solderparty/bbq20kbd_hw/bbq20_keyboard_case.step

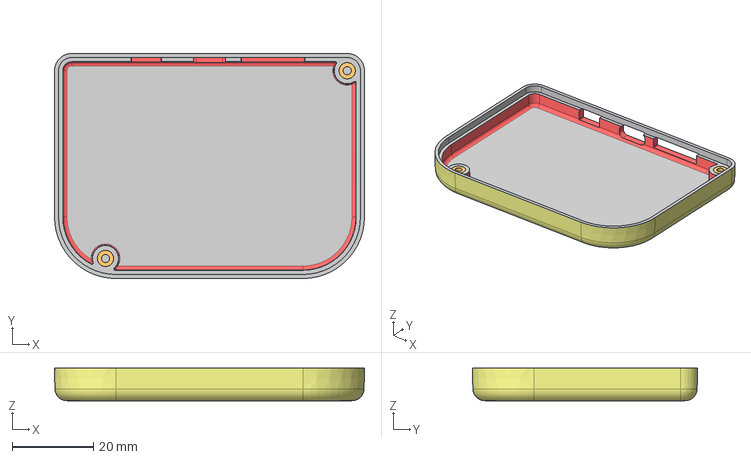
[picture p3: CAD file, 2022-05-10]
bbq20_keyboard_case.step
76.3 x 55.4 x 8.00 mm
