solderparty/bbq20kbd_hw/schematics.pdf

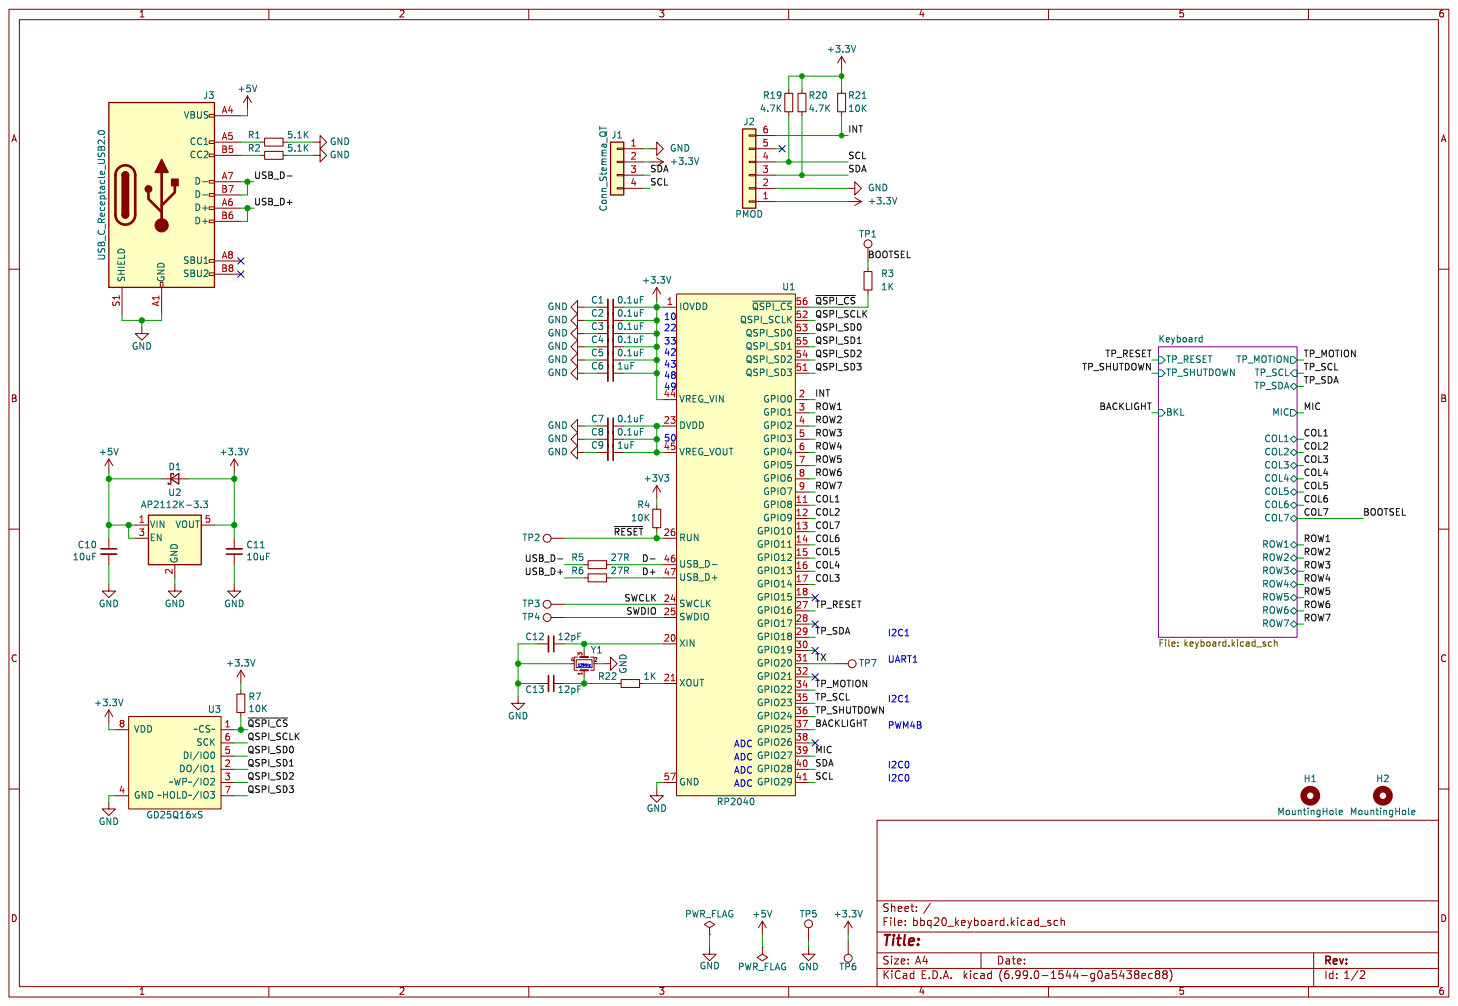
[picture p4: page 1]

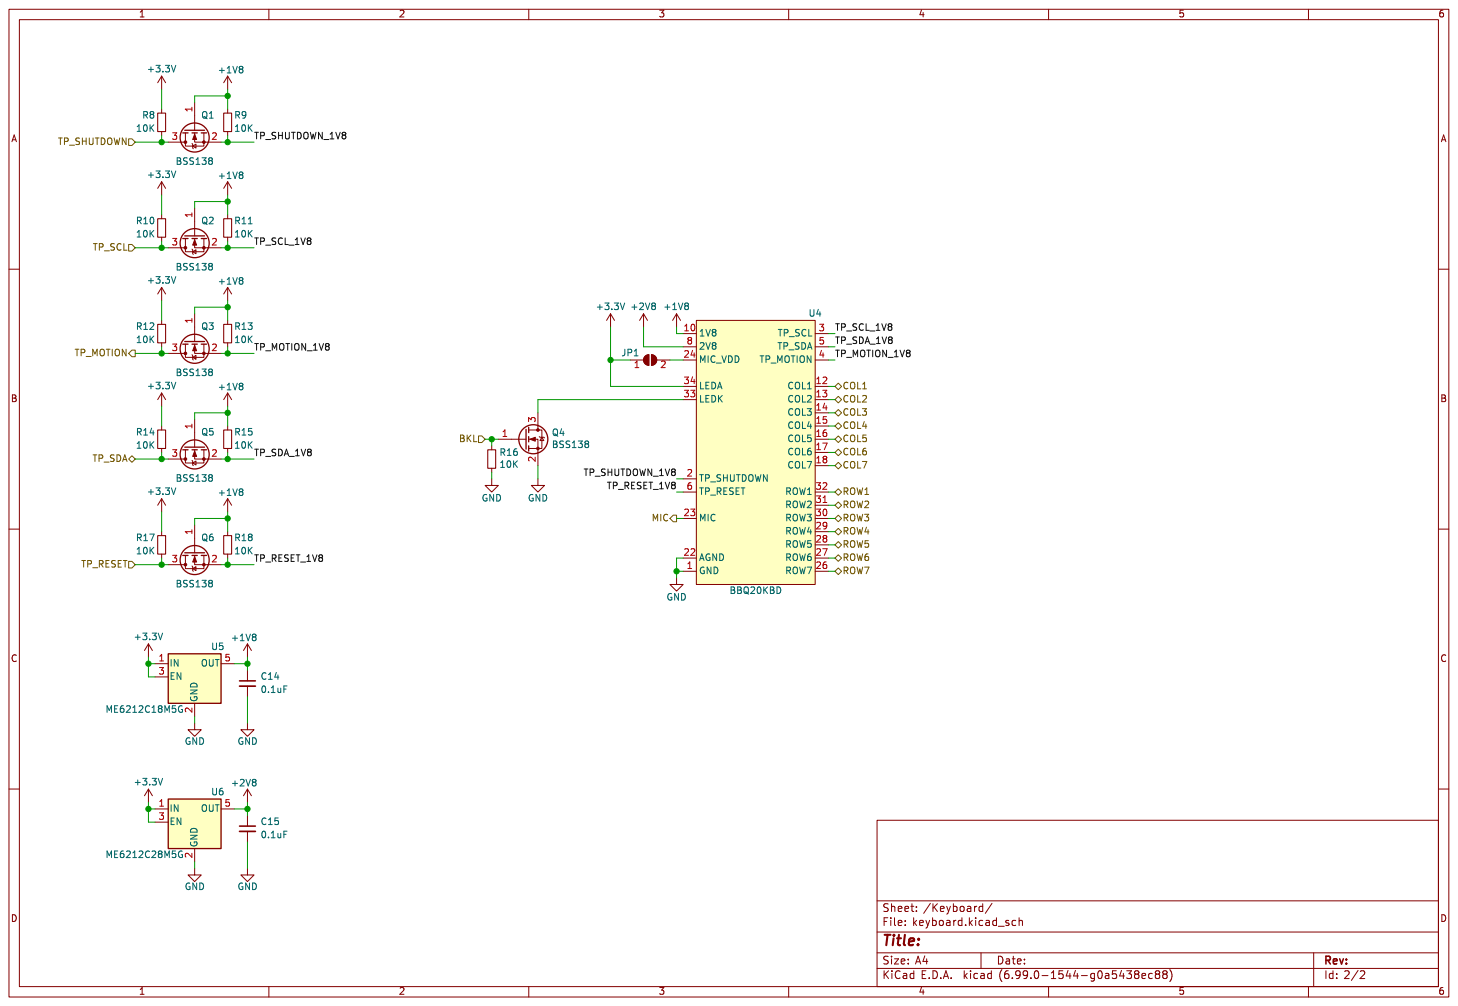
[picture p5: page 2]
