solderparty/bbq20kbd_hw/bbq20_keyboard.kicad_sch

## KiCad design bbq20_keyboard.kicad_sch (2022-05-07)

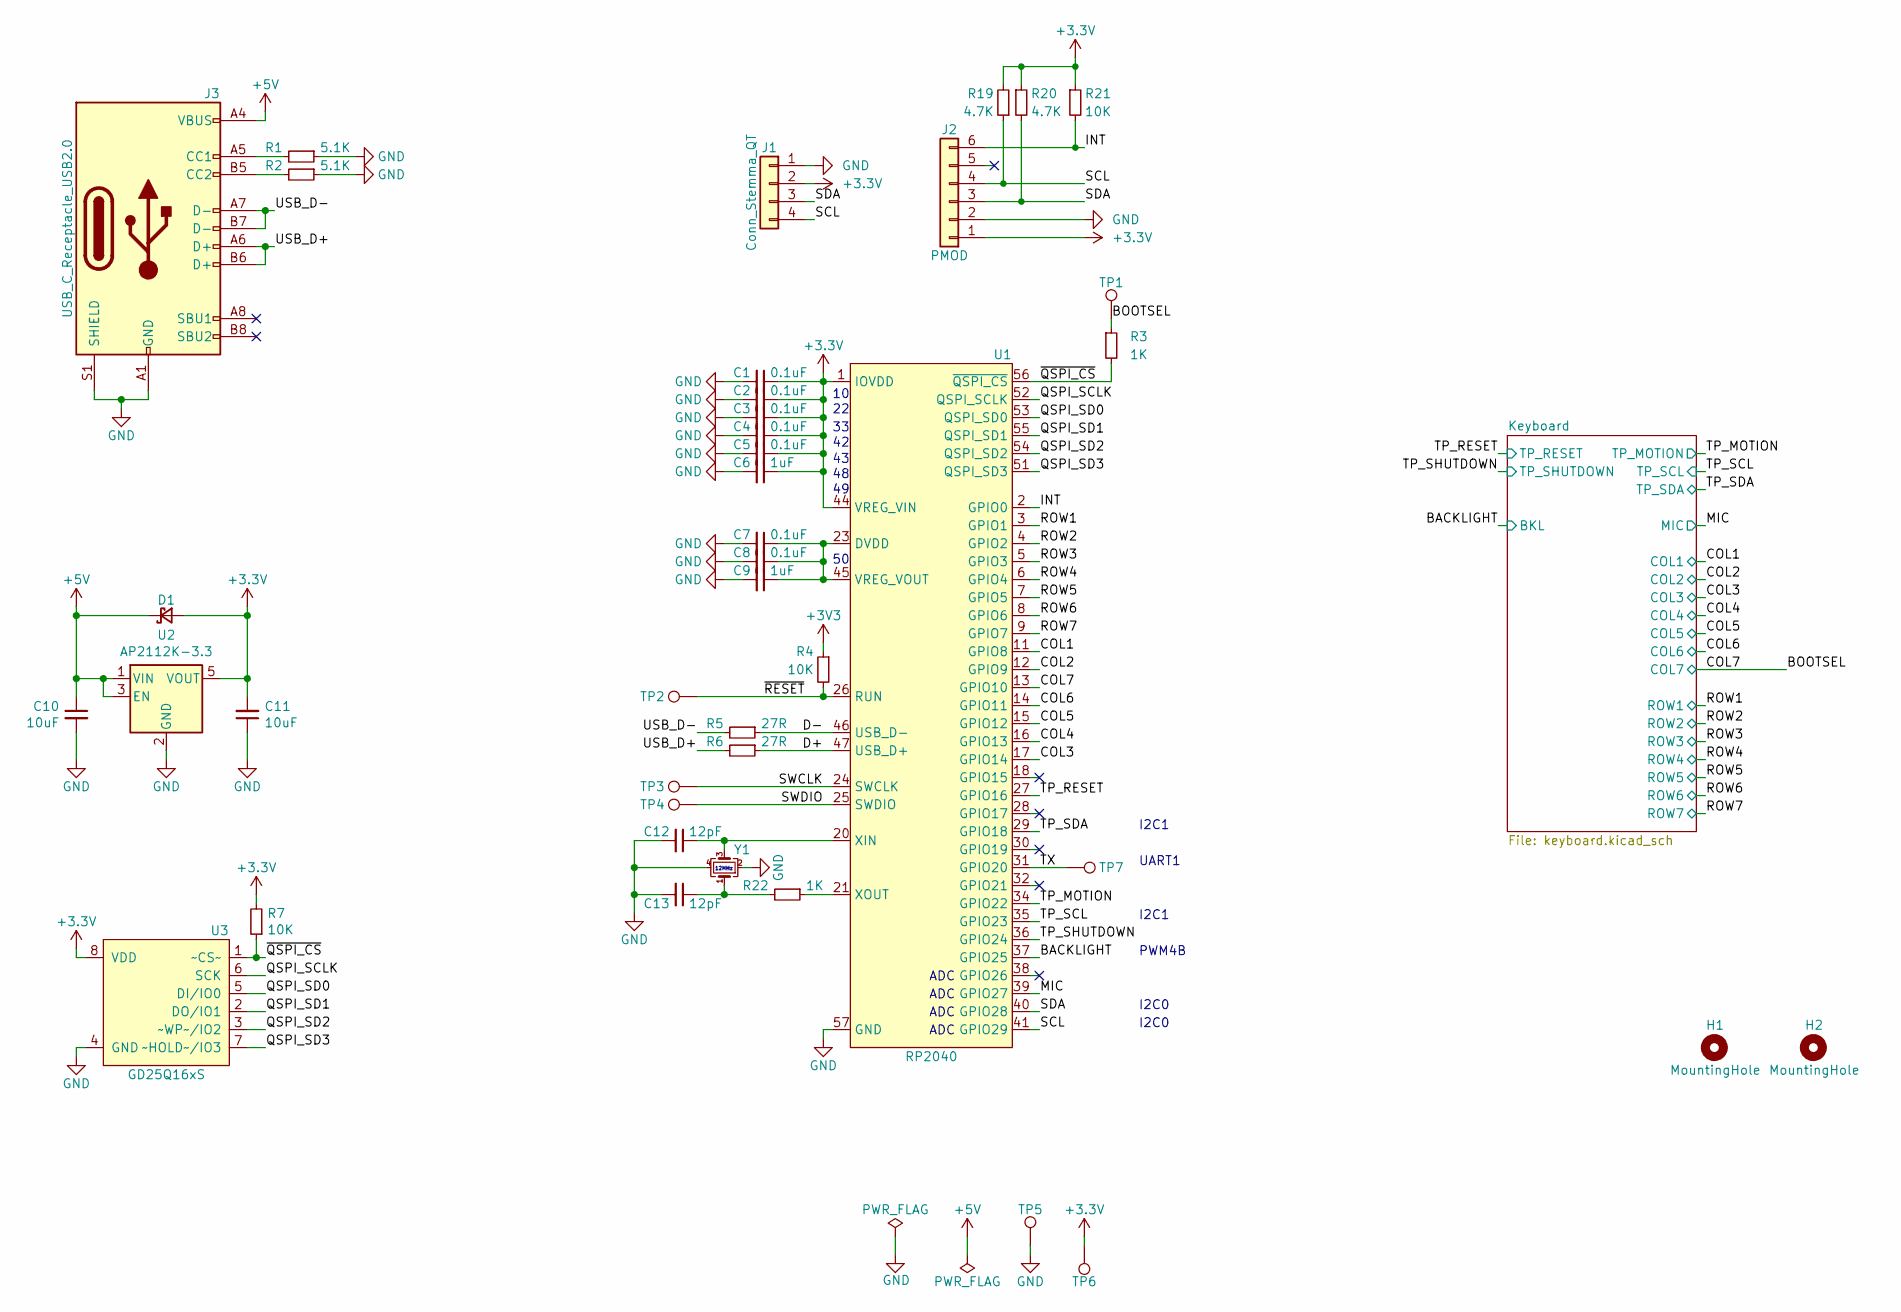
[picture p6: schematic bbq20_keyboard.kicad_sch]

Parts:
C1, C2, C3, C4, C5, C7, C8: 0.1uF; C_0603_1608Metric
C6, C9: 1uF; C_0603_1608Metric
C10, C11: 10uF; C_0603_1608Metric
C12, C13: 12pF; C_0603_1608Metric
D1: D_Schottky_Small; D_SOD-323; LCSC C114023
H1, H2: MountingHole; MountingHole_2.7mm_M2.5
J1: Conn_Stemma_QT; JST_SH_SM04B-SRSS-TB_1x04-1MP_P1.00mm_Horizontal; LCSC C145956
J2: PMOD; PMODPinHeader_1x06_P2.54mm_Horizontal
J3: USB_C_Receptacle_USB2.0; USB_C_Receptacle_HRO_TYPE-C-31-M-12; LCSC C165948
R1, R2: 5.1K; R_0603_1608Metric
R3, R22: 1K; R_0603_1608Metric
R4, R7, R21: 10K; R_0603_1608Metric
R5, R6: 27R; R_0603_1608Metric
R19, R20: 4.7K; R_0603_1608Metric
TP1: TP_USBBOOT; TestPoint_Pad_D1.5mm
TP2: TP_RESET; TestPoint_Pad_D1.5mm
TP3: TP_SWCLK; TestPoint_Pad_D1.5mm
TP4: TP_SWDIO; TestPoint_Pad_D1.5mm
TP5: TP_GND; TestPoint_Pad_D1.5mm
TP6: TP_3V3; TestPoint_Pad_D1.5mm
TP7: TP_TX; TestPoint_Pad_D1.5mm
U1: RP2040; QFN-56_EP_7x7_Pitch0.4mm
U2: AP2112K-3.3; SOT-23-5; LCSC C51118
U3: GD25Q16xS; SSOP-8_5.25x5.24mm_P1.27mm; LCSC C79074
Y1: XYDBPCNANF-12MHZ; Crystal_SMD_2520-4Pin_2.5x2.0mm; LCSC C709001

Connections:
+3.3V: C1.1, C2.1, C3.1, C4.1, C5.1, C6.1, C11.2, D1.2 (A), J1.2, J2.1, R7.2, R19.2, R20.1, R21.1, TP6.1, U1.1 (IOVDD), U1.10 (IOVDD), U1.22 (IOVDD), U1.33 (IOVDD), U1.42 (IOVDD), U1.43 (ADC_AVDD), U1.44 (VREG_VIN), U1.48 (USB_VDD), U1.49 (IOVDD), U2.5 (VOUT), U3.8 (VDD)
+3V3: R4.1
+5V: C10.1, D1.1 (K), J3.A4 (VBUS), J3.A9 (VBUS), J3.B4 (VBUS), J3.B9 (VBUS), U2.1 (VIN), U2.3 (EN)
BACKLIGHT: U1.37 (GPIO25)
BOOTSEL: R3.1, TP1.1, U1.13 (GPIO10)
COL1: U1.11 (GPIO8)
COL2: U1.12 (GPIO9)
COL3: U1.17 (GPIO14)
COL4: U1.16 (GPIO13)
COL5: U1.15 (GPIO12)
COL6: U1.14 (GPIO11)
D+: R6.1, U1.47 (USB_D+)
D-: R5.1, U1.46 (USB_D-)
GND: C1.2, C2.2, C3.2, C4.2, C5.2, C6.2, C7.2, C8.2, C9.2, C10.2, C11.1, C12.2, C13.2, J1.1, J2.2, J3.A1 (GND), J3.A12 (GND), J3.B1 (GND), J3.B12 (GND), J3.S1 (SHIELD), R1.1, R2.1, TP5.1, U1.19 (TESTEN), U1.57 (GND), U2.2 (GND), U3.4 (GND), U3.9 (GND), Y1.2, Y1.4
INT: J2.6, R21.2, U1.2 (GPIO0)
MIC: U1.39 (GPIO27)
unnamed: C7.1, C8.1, C9.1, U1.23 (DVDD), U1.45 (VREG_VOUT), U1.50 (DVDD)
unnamed: C12.1, U1.20 (XIN), Y1.3
unnamed: C13.1, R22.2, Y1.1
unnamed: J3.A5 (CC1), R1.2
unnamed: J3.B5 (CC2), R2.2
unnamed: R22.1, U1.21 (XOUT)
QSPI_SCLK: U1.52 (QSPI_SCLK), U3.6 (SCK)
QSPI_SD0: U1.53 (QSPI_SD0), U3.5 (DI/IO0)
QSPI_SD1: U1.55 (QSPI_SD1), U3.2 (DO/IO1)
QSPI_SD2: U1.54 (QSPI_SD2), U3.3 (~WP~/IO2)
QSPI_SD3: U1.51 (QSPI_SD3), U3.7 (~HOLD~/IO3)
ROW1: U1.3 (GPIO1)
ROW2: U1.4 (GPIO2)
ROW3: U1.5 (GPIO3)
ROW4: U1.6 (GPIO4)
ROW5: U1.7 (GPIO5)
ROW6: U1.8 (GPIO6)
ROW7: U1.9 (GPIO7)
SCL: J1.4, J2.4, R19.1, U1.41 (GPIO29)
SDA: J1.3, J2.3, R20.2, U1.40 (GPIO28)
SWCLK: TP3.1, U1.24 (SWCLK)
SWDIO: TP4.1, U1.25 (SWDIO)
TP_MOTION: U1.34 (GPIO22)
TP_RESET: U1.27 (GPIO16)
TP_SCL: U1.35 (GPIO23)
TP_SDA: U1.29 (GPIO18)
TP_SHUTDOWN: U1.36 (GPIO24)
TX: TP7.1, U1.31 (GPIO20)
USB_D+: J3.A6 (D+), J3.B6 (D+), R6.2
USB_D-: J3.A7 (D-), J3.B7 (D-), R5.2
~QSPI_CS: R3.2, R7.1, U1.56 (~QSPI_CS), U3.1 (~CS~)
~RESET: R4.2, TP2.1, U1.26 (RUN)

Notes on the sheet:
12MHz
ADC
I2C1
UART1
PWM4B
I2C0
