solderparty/bbq20kbd_hw/(commit log)

2022-03-07 Initial import
    [bbq20_keyboard.kicad_pcb, bbq20_keyboard.kicad_sch, keyboard.kicad_sch]
2022-05-07 Production release
    [bbq20_keyboard.kicad_pcb, bbq20_keyboard.kicad_sch, keyboard.kicad_sch]
2022-05-10 Add case 3d model
    [bbq20_keyboard_case.step]
2022-05-20 Add files via upload
    Added Step File with PCB, Components, Keyboard Cutout, and Double Sided Tape Gap
